SFUSatClub/Amp_Dev/README.md

#RF Amplifier Demo Board
Evaluation board design for a power amplifier and a low noise amplifier.
