SFUSatClub/Amp_Dev/Amp_Dev.sch

## KiCad design Amp_Dev.sch (2017-07-28)

Schematic: Amp_Dev.sch

Parts:
C1, C23: 10uF; CP_Tantalum_Case-B_EIA-1411-21_Reflow; Part Number TAJB106K016R; Digi-Key 478-1673-1-ND
C2, C12, C13, C15, C19, C32, C35: 1uF; C_0402; Part Number GRM155R61A105KE15D; Digi-Key 490-12701-1-ND
C3, C4, C25, C29: 100pF; C_0402; Part Number GRM1555C1H101JA01D; Digi-Key 490-5922-1-ND
C5, C16, C26: 2.2uF; C_0402; Part Number JMK105BJ225MVHF; Digi-Key 587-3710-1-ND
C6, C18: 390pF; C_0402; Part Number GRM1555C1H391JA01J; Digi-Key 490-6236-1-ND
C7, C10: 0.01uF; C_0402; Part Number GRM155R71E103KA01D; Digi-Key 490-1312-1-ND
C8: 220pF; C_0402; Part Number GRM1555C1H221JA01E; Digi-Key 490-1293-1-ND
C9: 22pF; C_0402; Part Number GRM1555C1H220JZ01E; Digi-Key 490-11382-1-ND
C11, C17: 56pF; C_0402; Part Number GRM1555C1H560JA01D; Digi-Key 490-1288-1-ND
C14, C30, C31, C33, C37, C38: 0.1uF; C_0402; Part Number 0402ZD104KAT2A; Digi-Key 478-1129-1-ND
C20: DNP; C_0402
C21: 0.1uF; C_0402; Part Number GRM155R71C104KA88D; Digi-Key 490-3261-1-ND
C22, C27: 10pF; C_0402; Part Number GJM1555C1H100JB01D; Digi-Key 490-3113-1-ND
C24: 27pF; C_0402; Part Number GJM1555C1H270JB01D; Digi-Key N/A
C28: 1.2pF; C_0402; Part Number GJM1555C1H1R2BB01D; Digi-Key 490-8085-1-ND
C34: 10uF; C_1210; Part Number GRM32DR71E106KA12L; Digi-Key 490-1867-1-ND
C36: 10uF; C_1210; Part Number GRM32DR71E106KA12L; Digi-Key 81-GRM32DR71E106KA12
C39: 8.2pF; C_0402; Part Number GJM1555C1H8R2BB01D; Digi-Key 490-11240-1-ND
C40: 8pF; C_0402; Part Number GJM1555C1H8R0BB01D; Digi-Key 490-11238-1-ND
C41: 3pF; C_0402; Part Number GJM1555C1H3R0BB01D; Digi-Key 490-8095-1-ND
C42: 10pF; C_0402; Part Number GJM1555C1H100FB01D; Digi-Key 490-11189-1-ND
C43: 3.3pF; C_0402; Part Number GJM1555C1H3R3BB01D; Digi-Key 490-8097-1-ND
C44: 10uF; CP_Tantalum_Case-C_EIA-2312-28_Reflow; Part Number TAJC106M025R; Digi-Key 478-3896-1-ND
D1, D2, D3, D4, D5, D6: PESD5Zx; PESD57zx; Part Number PESD5Z3.3,115; Digi-Key 1727-5814-1-ND
J1, J2, J10, J13, J20, J21, J22: SMA; SMA-Vert-TH; Part Number 5-1814832-1; Digi-Key A97594-ND
J3, J4, J6, J8, J9, J12, J16, J17, J18: TEST_1P; Measurement_Point_Round-SMD-Pad_Big
J5, J7, J15: CONN_01X03; Socket_Strip_Straight_1x03; Part Number PRPC003SAAN-RC; Digi-Key S1011EC-03-ND
J11, J14: CONN_01X02; 2x01In_Header_v2; Part Number PRPC002SAAN-RC; Digi-Key S1011EC-02-ND
L1: 22nH; L_0402; Part Number 0402CS-22NXGLW; Digi-Key N/A
L2: 8.2nH; L_0402; Part Number 0402CS-8N2XJLW; Digi-Key N/A
L3: 4.3nH; L_0402; Part Number 0402CS-4N3XGLW; Digi-Key N/A
L4: 24nH; L_0402; Part Number 0402CS-24NXGLW; Digi-Key N/A
L5: 12.55nH; L_0402; Part Number 1606-10J; Digi-Key N/A
L6, L12, L13, L14: 0R0; L_0603; Part Number RMC1/16JPTP; Digi-Key N/A
L7: 8.7nH; L_0603; Part Number LQW18AN8N7G8ZD; Digi-Key 490-15755-1-ND
L8: 9.5nH; L_0603; Part Number LQW18AN9N5G8ZD; Digi-Key 490-15763-1-ND
L9: 24nH; L_0603; Part Number LQW18AN24NG8ZD; Digi-Key 490-15662-1-ND
L10: 7.5nH; L_0603; Part Number LQW18AN7N5G8ZD; Digi-Key 490-15745-1-ND
L11: 22nH; L_0603; Part Number LQW18AN22NG8ZD; Digi-Key 490-15658-1-ND
Q1: DMN2075U; SOT23_DMN2075U; Part Number DMN2075U-7; Digi-Key DMN2075U-7DICT-ND
R1, R8: 220R; R_0402; Part Number RMC1/16S-221JTH; Digi-Key N/A
R2, R7, R14: 1K; R_0402; Part Number RC0402JR-071KL; Digi-Key 311-1.0KJRCT-ND
R3, R4: 390R; R_0402; Part Number RMC1/16S-391JTH; Digi-Key N/A
R5: 0R05; C_0603; Part Number BLM18EG221SN1D; Digi-Key 490-3992-1-ND
R6: 1210; R_0402; Part Number RC0402FR-071K21L; Digi-Key 311-1.21KLRCT-ND
R9: 100; R_0402; Part Number RC0402FR-07100RL; Digi-Key 311-100LRCT-ND
R10, R11, R12, R13: 10K; R_0402; Part Number RC0402JR-0710KL; Digi-Key 311-10KJRCT-ND
R15, R16: 1k; R_0402; Part Number RC0402JR-071KL; Digi-Key 311-1.0KJRCT-ND
R17: 287R; R_0402; Part Number RC0402FR-07287RL; Digi-Key YAG3089CT-ND
RV1: POT; TC33_SMD; Part Number TC33X-2-103E; Digi-Key TC33X-103ECT-ND
U1: MML09211H; 8-VFDFN; Part Number MML09211HT1; Digi-Key MML09211HT1CT-ND
U2: RF6886; QFN-24; Part Number RF6886TR13; Digi-Key 689-1091-1-ND
U3: LMV358; TSSOP-8_4.4x3mm_Pitch0.65mm; Part Number LMV358IYDT; Digi-Key 497-10524-1-ND
U4: SN74LVC1G17; SOT_23_5; Part Number SN74LVC1G17DBVR; Digi-Key 296-11933-1-ND
U5: TLV702; SOT_23_5; Part Number TLV70231DBVT; Digi-Key 296-27894-1-ND
U6: LTC2644; 12-TSSOP; Part Number LTC2644CMS-L8#PBF; Digi-Key LTC2644CMS-L8#PBF-ND
U7: RT9183; TO-263-5Lead; Part Number RT9183HGM5; Digi-Key 1028-1183-1-ND

Notes on the sheet:
LNA
430MHz
Amplifier
Output Power Feedback
Output Power Control
Ferrite bead, 220 Ohm @ 100MHz
PWM DAC
Diplexer
*NOTE*: The LNA, PA, and diplexer will be on separate boards. Make sure to lay out the board such that they are separate blocks with mouse bites
HPF
LPF
R10,R11/R12,R13 * (Vref - Vsense) = Vout
0.28V to 3.1V
