SFUSatClub/Amp_Dev/(threads)

Thread 1 (2017-07-14):

Find wall wart for PA board

TobiNakamura, 2017-07-14:
Find USB or barrel jack 5V output, > 4W.

Alenux55, 2017-07-27:
We have no barrel jack connector; don't bother finding a wall wart

Closed 2017-07-27.

Thread 2 (2017-07-14):

Make board 10cm X 10cm

TobiNakamura, 2017-07-14:
full board should be max. 10cmx10cm. LNA and PA section should be electrically isolated and separated by mouse bites.

Alenux55, 2017-07-16:
Added in 4f5028d

Closed 2017-07-16.

Thread 3 (2017-07-14):

Add vertical mount SMA

TobiNakamura, 2017-07-14:

Alenux55, 2017-07-17:
Actually, we could do right-angle through hole connectors as well, like [5-1814400-1](https://www.digikey.ca/products/en?keywords=A97593-ND) from TE Connectivity, but we already bought the vertical ones from eBay didn't we

Alenux55, 2017-07-19:
Done in 7f22d8f

Closed 2017-07-19.

Thread 4 (2017-07-14):

Calculate subtractor and comparator feedback resistances

TobiNakamura, 2017-07-14:

Alenux55, 2017-07-27:
Matches the topology in the [datasheet](https://www.google.com/url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)

Closed 2017-07-27.

Thread 11 (2017-08-12):

L5 has to be replaced with 1606 footprint

TobiNakamura, 2017-08-12:
Currently it is a 0402, has to be replaced with 1606 footprint already in the kicad library
