SFUSatClub/Amp_Dev/(commit log)

2017-07-01 configured library
    [Amp_Dev.kicad_pcb, Amp_Dev.sch]
2017-07-04 Added LNA components based on 400 MHz sch
    [Amp_Dev.sch]
2017-07-05 initial PA schematic
    [Amp_Dev.sch]
2017-07-05 RFout feedback circuit
    [Amp_Dev.sch]
2017-07-06 added power supply
    [Amp_Dev.sch]
2017-07-07 Added fixed 3V1 LDO
    [Amp_Dev.sch]
2017-07-07 Added DAC and supporting components
    -Added TVS Diode to 3V1 supply output
    -Associated 3V1 LDO with SOT_23_5
    -Added DAC and associated it with 12-TSSOP
    -Added level shifter and associated it with SOT_23_5
    [Amp_Dev.sch]
2017-07-07 Changed 3V1 LDO caps from 10uF to 1 uF
    [Amp_Dev.sch]
2017-07-09 split sch to LNA and PA
    [Amp_Dev.sch]
2017-07-14 added PA input power connector
    [Amp_Dev.sch]
2017-07-16 Added diplexer
    Also annotated schematic
    [Amp_Dev.sch]
2017-07-16 Added board outline to layout
    [Amp_Dev.kicad_pcb]
2017-07-16 Added dimensioning lines
    [Amp_Dev.kicad_pcb]
2017-07-17 Changed diplexer capacitor values
    [Amp_Dev.sch]
2017-07-17 Added information and footprints to LNA block
    [Amp_Dev.sch]
2017-07-18 Generated netlist for LNA components
    Also added flood planes to top and bottom of board, and did initial LNA component placement
    [Amp_Dev.kicad_pcb]
2017-07-18 Refreshed footprints to add refdes to inductors and resistors
    [Amp_Dev.kicad_pcb]
2017-07-18 Updated layout
    -Changed board thickness to 0.6 mm
    -Used 0.7 mm RF trace width, resulting in 51.8 ohm impedance
    -Used 0.5 mm power trace width, which is good for about 1.5 A
    -Routed all LNA-related components
    [Amp_Dev.kicad_pcb]
2017-07-18 Fixed trace terminations
    Adjusted RF trace widths near pads to keep the pad size the same
    [Amp_Dev.kicad_pcb]
2017-07-19 set values to PA feedback circuit
    [Amp_Dev.sch]
2017-07-19 Added diplexer board and other changes
    -Adjusted RF track width to 0.6 mm from 0.7 mm
    -Added diplexer board
    -Added extra board cuts and mouse bites
    [Amp_Dev.kicad_pcb, Amp_Dev.sch]
2017-07-19 Changed sch text from '1 kOhm @ 100 MHz' to '220 Ohm @ 100 MHz'
    [Amp_Dev.sch]
2017-07-20 Further schematic updates
    -Added more component footprints
    -Forward annotated new components to PCB
    [Amp_Dev.kicad_pcb, Amp_Dev.sch]
2017-07-20 Added powerand output power control circuitry to sch and layout
    [Amp_Dev.kicad_pcb, Amp_Dev.sch]
2017-07-21 associated footprint for op-amp
    [Amp_Dev.sch]
2017-07-24 assigned footprint to PA section
    [Amp_Dev.sch]
2017-07-24 Almost finished adding all footprints
    -Added footprints to all components
    -Removed J15 and J19
    [Amp_Dev.sch]
2017-07-24 Forward annotated more PA components
    [Amp_Dev.kicad_pcb]
2017-07-26 Routed PA power board
    Sch:
    -For LF, made L6 an 0603 0 ohm resistor like L12, L13, and L14
    -Changed net 3.1V to 3V1
    Layout:
    -Routed all signals
    -Added 1.5 cm spaced via fence around all boards (~1/20 wavelength)
    -Fixed unconnected nets
    -Added some silkscreen labels
    [Amp_Dev.kicad_pcb, Amp_Dev.sch]
2017-07-26 Added silkscreen and another PA board
    [Amp_Dev.kicad_pcb]
2017-07-28 added PA control header. resolves #7
    [Amp_Dev.kicad_pcb, Amp_Dev.sch]
2017-07-28 hid test point reference. resolves #10
    [Amp_Dev.kicad_pcb]
2017-07-28 placed reference designators. resolves #9
    [Amp_Dev.kicad_pcb]
2017-07-28 moved L4 closer to RF trace
    [Amp_Dev.kicad_pcb]
2017-07-28 made text thinner
    [Amp_Dev.kicad_pcb]
2017-07-28 moved L1 closer to RF path
    [Amp_Dev.kicad_pcb]
2017-07-28 Duplicated PA board
    [Amp_Dev.kicad_pcb]
2017-07-28 generated and reviewed gerbers
    [Amp_Dev-B.Cu.gbr, Amp_Dev-B.Mask.gbr, Amp_Dev-B.SilkS.gbr, Amp_Dev-Edge.Cuts.gbr, Amp_Dev-F.Cu.gbr, Amp_Dev-F.Mask.gbr, Amp_Dev-F.Paste.gbr, Amp_Dev-F.SilkS.gbr]
2017-07-28 updated LNA footprint to one with 0.3mm drill
    [Amp_Dev-B.Cu.gbr, Amp_Dev-B.Mask.gbr, Amp_Dev-B.SilkS.gbr, Amp_Dev-Edge.Cuts.gbr, Amp_Dev-F.Cu.gbr, Amp_Dev-F.Mask.gbr, Amp_Dev-F.Paste.gbr, Amp_Dev-F.SilkS.gbr]
